Oren14Dani/autonomous-electric-car/README.md

# autonomous-electric-car
C++ programming development of a autonomous (self driving) vehicle system , using 2 Microcontrollers: Arduino Mega and Arduino Uno
