Oren14Dani/autonomous-electric-car/project description.pdf

חזור לתוכן עניינים

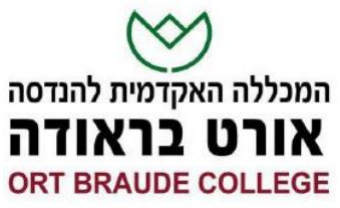
[picture p1: figure]

## פרויקט תחרותי

שם הסטודנט, תעודת זהות, מייל: סער גוזלן , 204188403 , il.ac.braude.e@gozlan.saar

שם הסטודנט, תעודת זהות, מייל: אורן דנילוב , 203824545 , com.gmail@dani14oren

שם הסטודנט, תעודת זהות, מייל: שמעון קריכלי 212141428, , il.ac.braude.e@kricheli.shimon

מנחה: ד"ר בטו כץ

תאריך: 24.8.22

מחלקה: הנדסת חשמל ואלקטרוניקה

## תוכן עניינים

מבוא | : 4
תיאור המערכת | : 4

## מפתח איורים

4 | 1 Figure
5 | 2 Figure (https://ebraude-my.sharepoint.com/personal/oren_danilov_e_braude_ac_il/Documents/STUDY/competitive%20project/ספר%20פרויקט.docx)
7 | 3 Figure
7 | 4 Figure
8 | 5 Figure
8 | 6 Figure (https://ebraude-my.sharepoint.com/personal/oren_danilov_e_braude_ac_il/Documents/STUDY/competitive%20project/ספר%20פרויקט.docx)
8 | 7 Figure (https://ebraude-my.sharepoint.com/personal/oren_danilov_e_braude_ac_il/Documents/STUDY/competitive%20project/ספר%20פרויקט.docx)
8 | 8 Figure (https://ebraude-my.sharepoint.com/personal/oren_danilov_e_braude_ac_il/Documents/STUDY/competitive%20project/ספר%20פרויקט.docx)
9 | 9 Figure
9 | 10 Figure (https://ebraude-my.sharepoint.com/personal/oren_danilov_e_braude_ac_il/Documents/STUDY/competitive%20project/ספר%20פרויקט.docx)
10 | 11 Figure (https://ebraude-my.sharepoint.com/personal/oren_danilov_e_braude_ac_il/Documents/STUDY/competitive%20project/ספר%20פרויקט.docx)
10 | 12 Figure (https://ebraude-my.sharepoint.com/personal/oren_danilov_e_braude_ac_il/Documents/STUDY/competitive%20project/ספר%20פרויקט.docx)
10 | 13 Figure (https://ebraude-my.sharepoint.com/personal/oren_danilov_e_braude_ac_il/Documents/STUDY/competitive%20project/ספר%20פרויקט.docx)
10 | 14 Figure (https://ebraude-my.sharepoint.com/personal/oren_danilov_e_braude_ac_il/Documents/STUDY/competitive%20project/ספר%20פרויקט.docx)
10 | 15 Figure (https://ebraude-my.sharepoint.com/personal/oren_danilov_e_braude_ac_il/Documents/STUDY/competitive%20project/ספר%20פרויקט.docx)
11 | 16 Figure
11 | 17 Figure
12 | 18 Figure (https://ebraude-my.sharepoint.com/personal/oren_danilov_e_braude_ac_il/Documents/STUDY/competitive%20project/ספר%20פרויקט.docx)
12 | 19 Figure (https://ebraude-my.sharepoint.com/personal/oren_danilov_e_braude_ac_il/Documents/STUDY/competitive%20project/ספר%20פרויקט.docx)
12 | 20 Figure (https://ebraude-my.sharepoint.com/personal/oren_danilov_e_braude_ac_il/Documents/STUDY/competitive%20project/ספר%20פרויקט.docx)
13 | 21 Figure
14 | 22 Figure
16 | 23 Figure
17 | 24 Figure (https://ebraude-my.sharepoint.com/personal/oren_danilov_e_braude_ac_il/Documents/STUDY/competitive%20project/ספר%20פרויקט.docx)

## מבוא:

פרויקט זה עוסק בבנייה ותכנון של מערכת רכב אוטונומי תחרותי. מטרת הפרויקט הינה ניצחון בתחרות שבה מערכת הרכב, שעליו נמצא מקלט IR, צריך למצוא ולהגיע למקור של אות IR שמשודר במרחב על ידי משדר שנמצא בצידו האחר של המסדרון. כלומר, הרכב צריך לחפש ולהתביית על אות המשדר ולהגיע אליו. הסטודנטים בתחרות מחולקים לצוותים, ומכל צוות נדרש לבנות רכב אוטונומי תחרותי אשר תבצע 3 מסלולים שונים
.1 העגלה מוסטת בזווית של כ- 45 מעלות ביחס למשדר ללא מכשולים. .2 העגלה מיושרת עם המקור, אך ישנם שני מכשולים בדרך שמונעים קו ראיה בין המשדר למקלט, על הרכב למצוא את האות תוך התחמקות מהמכשולים ולהגיע אליו. .3 העגלה מוסטת בזווית של כ- 45 מעלות ביחס למשדר, אך הפעם עם מכשול בדרך. בנוסף, ישנו רכב נוסף במסלול שמתחרה איתנו.
את המסלולים הרכב צריך לבצע בזמן הקצר ביותר.

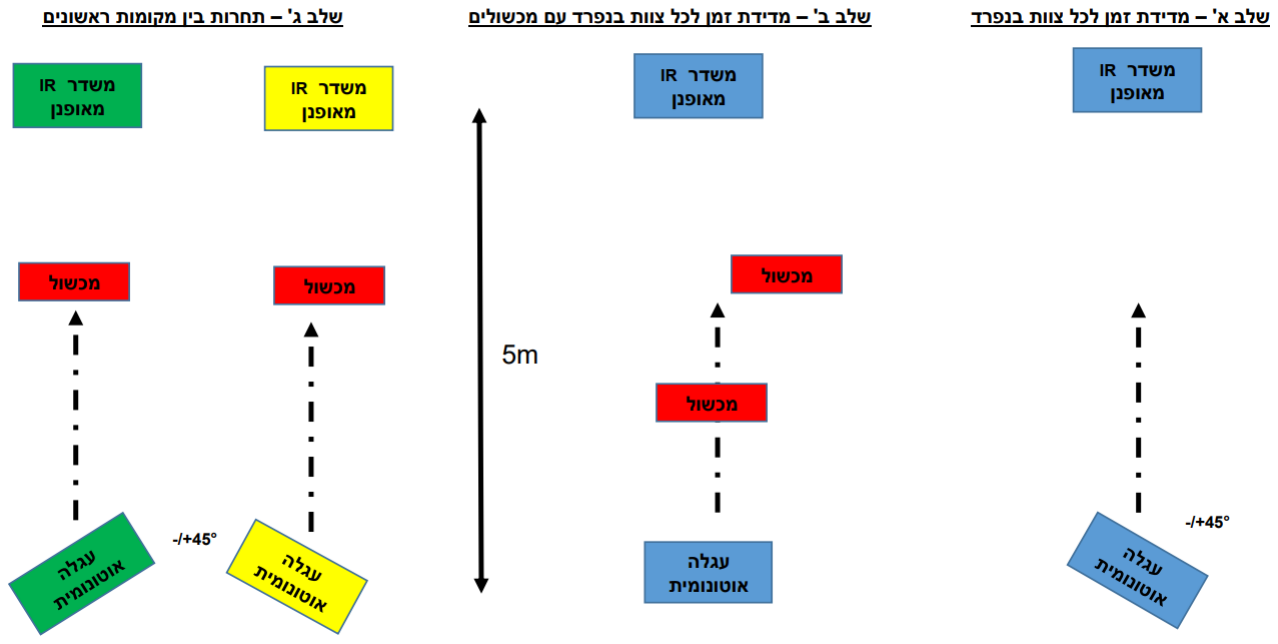
[picture p2: figure]

1 Figure

## תיאור המערכת:

המערכת בנויה מ2 מערכות עיקריות: מערכת שידור ו מערכת קליטה ובקרה.

מערכת השידור

מורכב מבקר Nano Arduino המחובר ל 3 משדרי 333IR, אשר משדרים לחלל אות בתדר kHz38 מאופנן PWM כך שאות המידע הוא גל ריבועי בתדרים Hz100 או Hz200 בהתאם למצב מתג ברירת התדרים.

מערכת הקליטה ובקרה

זה בעצם חלק מהמערכת הכוללת של הרכב.

מכיל 3 מקלטי 4838TSOP אשר אמונים על קליטת האות ופעולת דה-מודולציה על מנת לקבל את אות המידע ללא האות הנושא, כלומר, האות שהארדואינו קולט הוא אות המידע בלבד בתדרים Hz100 או Hz.200 המקלטים עצמם מבצעים דה-מודולציה.

את המקלטים הנחנו על גובה על מנת שיוכלו לקלוט יותר טוב וללא הפרעות וחסימות שיכולות להיווצר על ידי הרכיבים השונים שנמצאים על הרכב ובנוסף לכך עטפנו גליל קטן מסביב למקלט הראשי באיזולירבנד שחור על מנת שלא ייקלטו הפרעות כיוון שבשונה משני מהקלטים האחרים אין לו הגנה מהחזרים.

לרכב חיברנו גם 4 חישני מרחק -04HCSR על מנת שנוכל להתחמק ממכשולים ולכל חיישן מרחק כזה הוספנו נורת חיווי על מנת שנוכל לראות ויזואלית מתי המרחק שקולטים החיישנים קטן ממרחק הסף שהגדרנו למערכת.

את הגלגלים של הרכב אנו מניעים בעזרת 4 מנועי DC פשוטים המחוברים ל D293L

Shield Motor – רכיב הייעודי לארדואינו מגה/ אונו. רכיב זה מכיל 2 דרייברים למנועים שבעזרתם ניתן לחבר את מהנועים לארדואינו. לא ניתן לחבר את המנועים ישירות לארדואינו מכיוון שייתכן מצב שבו המנועים ייצרכו יותר זרם ממה שהפינים של הארדואינו מסוגלים לתת. את כל המערכת שמחוברת לרכב מפעילות 3 סוללות V3.7 מסוג 18650 שמחוברות לכניסת המתח של L293D Shield ה

דרישות המערכת

- המערכת תדע לזהות מקור IR בודד אשר נמצא בסוף המסלול, להתמקד עליו ולדעת לכוון את העגלה האוטונומית לכיוונו, תוך הימנעות ממכשולים ועצמים קיימים לאורך המסלול.
- המערכת תהיה מבוססת על בקר מסוג Arduino מקליטי IR ומשדרי IR , אשר ישמשו למציאת מקור השידור.
- המערכת תדע לנוע במרחב על גבי מרכב וגלגלים כפי שהוגדרו במשימה.
- הרכב יגיע ליעד לפחות באחד מהמסלולים - העגלה צריכה להגיע אל קרבת המשדר )רדיוס של 20 ס"מ( בזמן הקצר ביותר.

מפרט פונקציונלי

- יכולת קליטה והתבייתות על מקור IR ונסיעה אליו.
- יכולת זיהוי מכשולים ועצמים שונים בדרך והימנעות מפגיעה.
- יכולת נסיעה אוטונומית במסלול ללא התערבות אדם.
- יכולת סינון החזרי אור אשר מתחזים לשידור IR.

2 Figure

## מפרט טכני

| | מכלול תפקיד רכיבים
Arduino Nano בקר • • מתג בחירת תדר • 3 משדרי -333IR עם תדר גל נושא kHz38 mA20 • מסופק על ידי שנאי V5 מרשת החשמל | • יצירת ושידור אות המידע בתדרים Hz100/200 | מכלול שידור Tramission module
Arduino Mega • TSOP4838 receiver 3 • (de-modulator included) | • דה-מודולציה | מכלול קליטה module Receiver • קליטת אות ה IR-המאופנן
L293D motor driver • shield • 4 מנועי DC | • אחראי על נסיעת הרכב – מקבל פקודות מהארדואינו | מכלול הנעה
- 4 חיישני מרחק -HCSR 04 • נורות חיווי לכל חיישן • מרחק מקסימלי: m4 • מרחק מינימלי: cm2 | • זיהוי מכשולים • מניעת התנגשות | מכלול בלימה
Arduino Mega • • מסופק על ידי 3 סוללות 18650 סך הכל 11.1v | • עיבוד הנתונים • מתן פקודות לרכיבים שונים על פי התכנון | מכלול שליטה ובקרה

## תרשים מלבנים

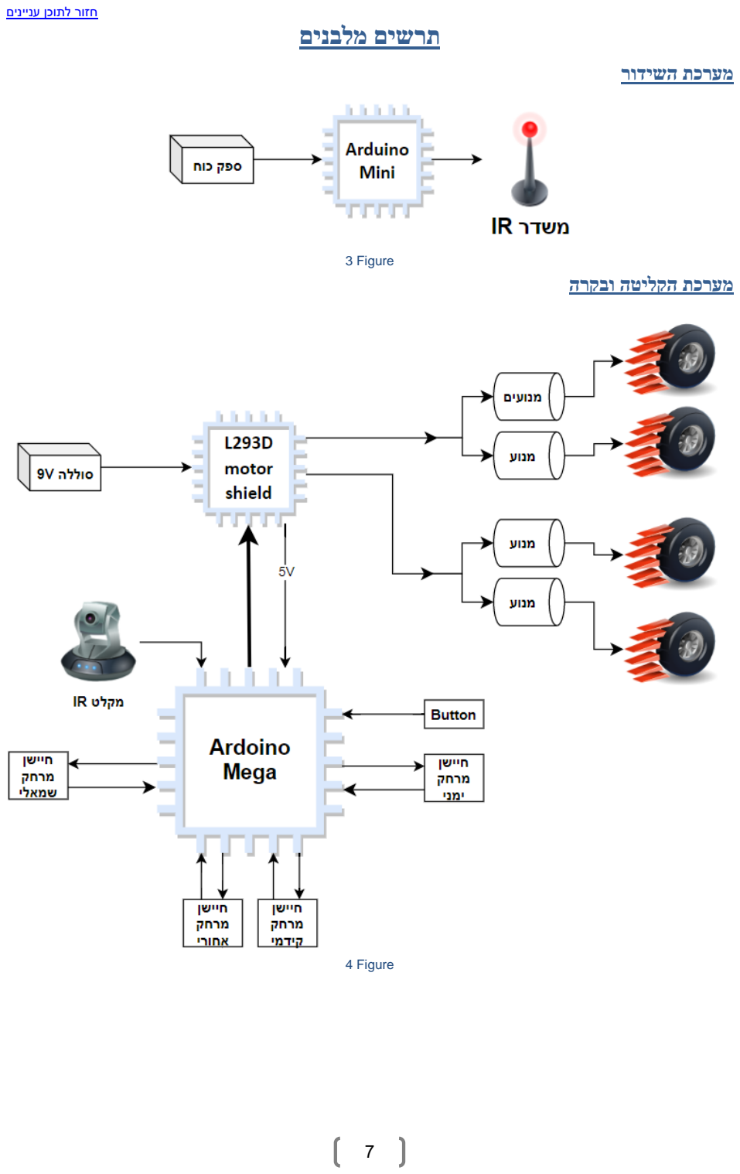
[picture p3: page 7]

מערכת השידור

3 Figure
מערכת הקליטה ו בקרה

4 Figure

## פירוט מכלולי המערכת

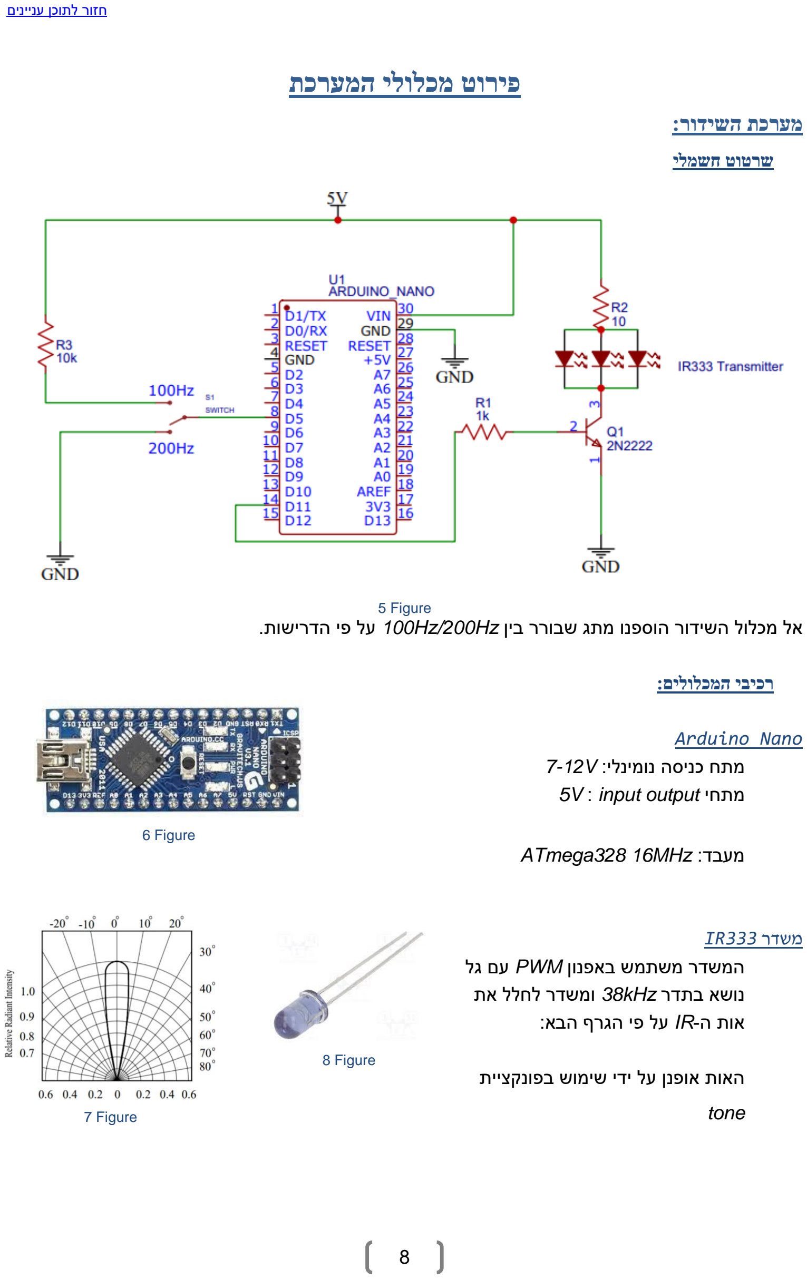
[picture p4: page 8]

7 Figure

מערכת השידור:

שרטוט חשמלי

5 Figure
אל מכלול השידור הוספנו מתג שבורר בין Hz/200Hz100 על פי הדרישות.

רכיבי המכלולים:

Arduino Nano
מתח כניסה נומינלי: V7-12
5V : input output | מתחי
ATmega328 16MHz : | מעבד

משדר 333IR
המשדר משתמש באפנון PWM עם גל נושא בתדר kHz38 ומשדר לחלל את אות ה-IR על פי הגרף הבא:

האות אופנן על ידי שימוש בפונקציית

tone

6 Figure

8 Figure

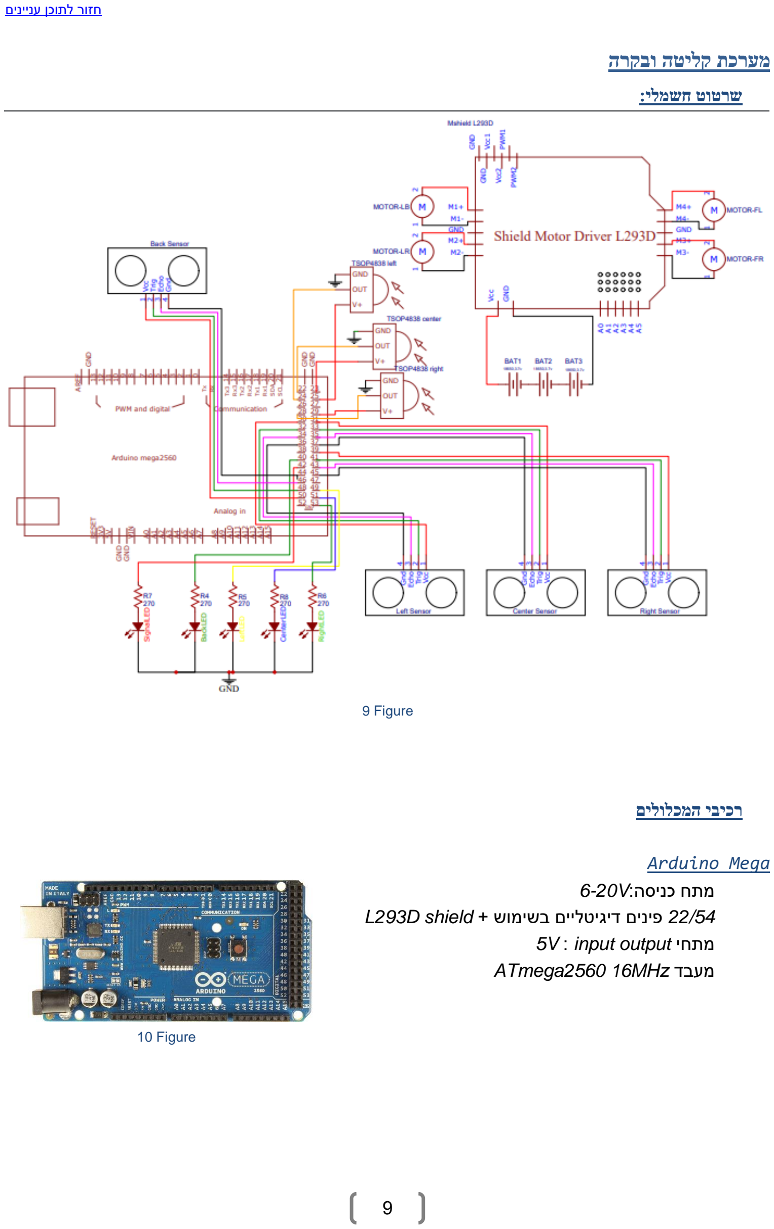
[picture p5: page 9]

מערכת קליטה ובקרה

שרטוט חשמלי:

9 Figure

רכיבי המכלולים

Arduino Mega
מתח כניסה:V6-20
22/54 פינים דיגיטליים בשימוש + shield D293L
5V : input output | מתחי
ATmega2560 16MHz | מעבד

10 Figure

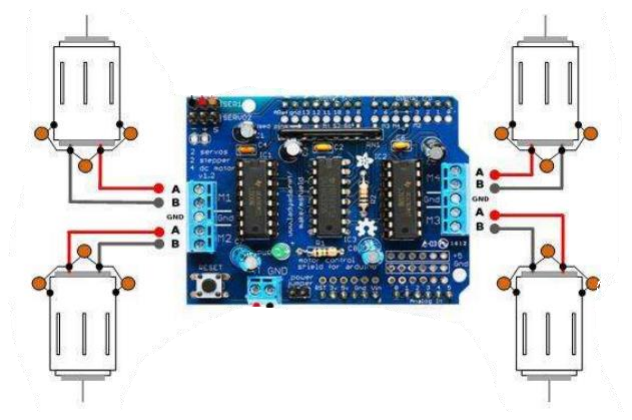
[picture p6: figure]
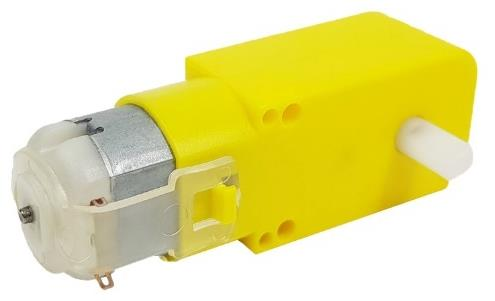
[picture p7: figure]

12 Figure

L293D Moter Driver Shield
מחובר ל- 4 מנועי DC
מתחים: V6-15
זרם למנוע: A1.2

DC motor
4 מנועי DC
מתחים: V4.5-9
זרם תחת עומס mA250~

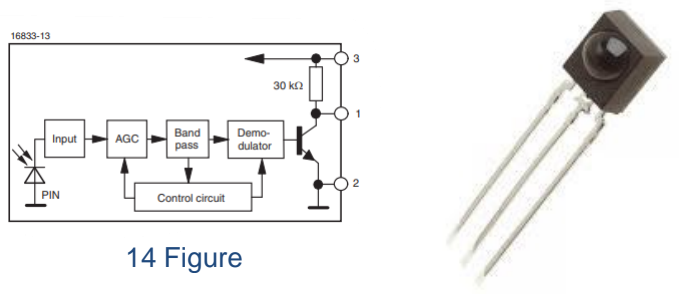
[picture p8: figure]
14 Figure

TSOP4838 IR receiver
Included de-modulator
מתחים: V2.5-5.5
טווח קליטה: kHz30-56

HCST-04
4 חיישני מרחק אולטרא סוני -04HCSR מתח וזרם עבודה: mA15 , V5
טווח מרחקים: m] ,4 0.02[

11 Figure

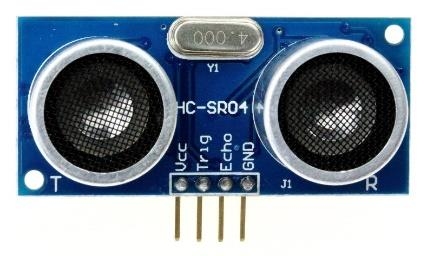
[picture p9: figure]

15 Figure

13 Figure

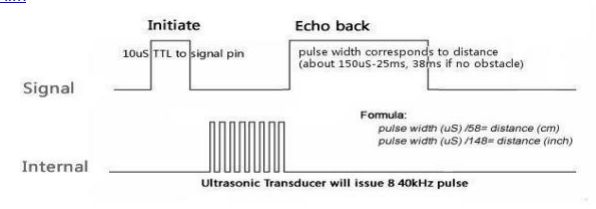
[picture p10: figure]

16 Figure
אופן מדידת אורך זמן פולס ECHO על ידי המערכת: החיישן מקבל מהארדואינו Trigger למשך 10 מיקרו שניות ולאחר מכן שולח אות בתדר kHz40 ומרים את Echo. האות עובר בחלל ולאחר מכן מוחזר אל הרכיב וכשזה קורה Echo יורד. הרכיב מודד את הזמן שפין Echo היה גבוהה.

חישוב המרחק
ע"י שימוש בנוסחה הפיזיקלית: Distance = time ∙ velocity נבצע חישוב למרחק שעבר אות ECHO מרגע שעזב את החיישן, פגע בעצם במרחב הוחזר בחזרה אל החיישן, כתלות במהירות האות שהיא מהירות הקול.

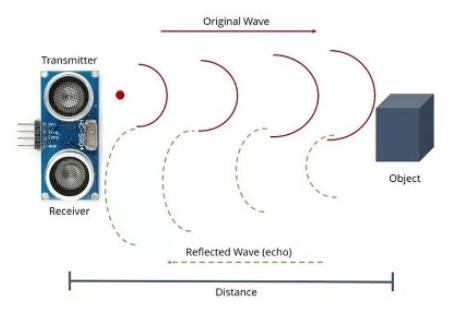
[picture p11: figure]

17 Figure
נשים לב שהאות במסעו הלוך וחזור למעשה עבר את המרחק distance פעמיים, לכן נחלק את התוצאה פי .2

Distance =

time ∙ velocity
2

Distance [m] =

ECHOtime[μ sec] ∙ Speed of Sound in air [

m
sec]

2

=

ECHOtime[μ sec] ∙ 343 [

m
sec]

2

= ECHOtime[μ sec] ∙

343
2

[

m
sec

]

נעבור ליחידות מרחק בcm:

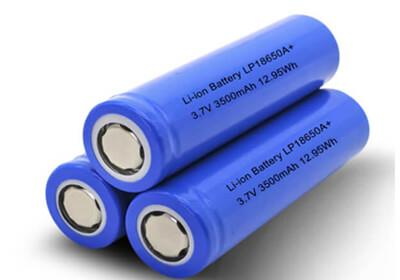
[picture p12: figure]

18 Figure

distance[cm] = ECHOtime[μ sec] ∙ 2

[

cm
c sec

] = ECHOtime[μ sec] ∙
2

c

[

cm
sec

]

= ECHOtime[μ sec] ∙

343
2

μ
c

[

cm
μ sec] ≈ ECHOtime[μ sec] ∙

1
58 [

cm
μ sec]

קיבלנו נוסחא לחישוב המרחק בעזרת מהירות הקול:

distance ≈

ECHOtime
58 [cm]

לפי הנוסחה שקיבלנו - נקבל את המרחק שנמדד בסנטימטר כאשר נחלק מדידת הזמן של האות פי 58 . לכן גם נוודא לקחת את זמן המחזור במיקרו שניות.

הערה: הרגישות שלנו תהיה לפי ס"מ, ויהיה עיגול מטה למספרים שלמים )משתמשים במשתנה int). כלומר, עבור מרחק של 45.8 ס"מ נראה פשוט 45 ס"מ.

מקורות מתח
כל המערכת מסופקת על ידי 3 סוללות מסוג 18650 בעלות מתח V3.7 כל אחת .

פעולת משדר-מקלט:

אחרי דמודולציה )מקלט( Hz:100 אחרי דמודולציה )מקלט( Hz:200

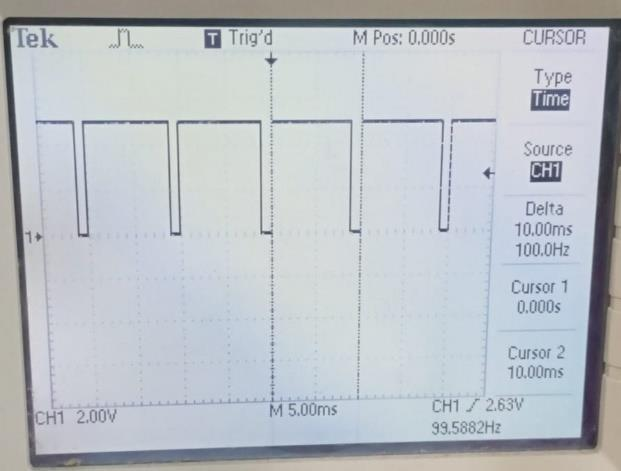
[picture p13: figure]

כפי שניתן לראות קיבלנו אותות נקיים לשני התדרים.

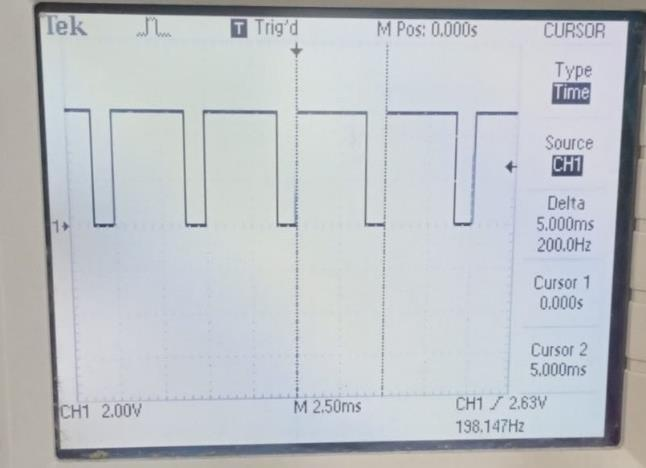
[picture p14: figure]

ניתן לראות שכיוונו את המשדר כך שישדר ms1 של LOW בשני התדרים וכך כיילנו אותו עם המקלט ובדקנו אם האות המתקבל הוא יציב.

19 Figure 20 Figure

## תרשים זרימה

תרשים הזרימה ממחיש את הלוגיקה העומדת מאחור הקוד.

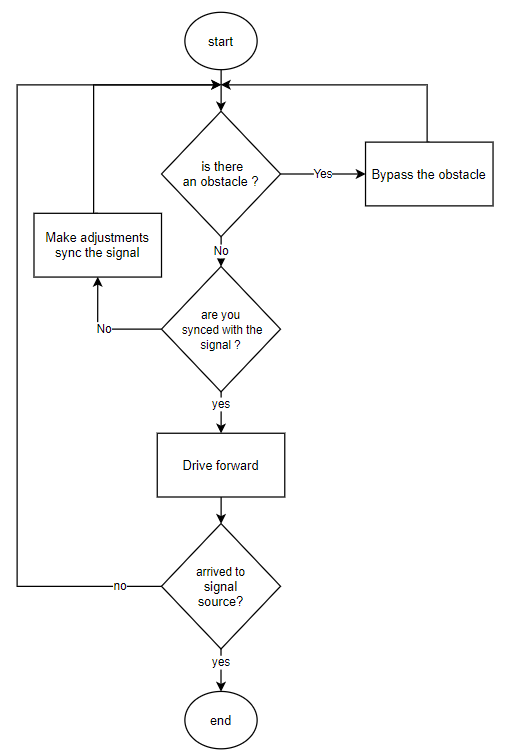
[picture p15: figure]

21 Figure

## מכונת מצבים

מכונת המצבים ממחישה את אופן מימוש הקוד.

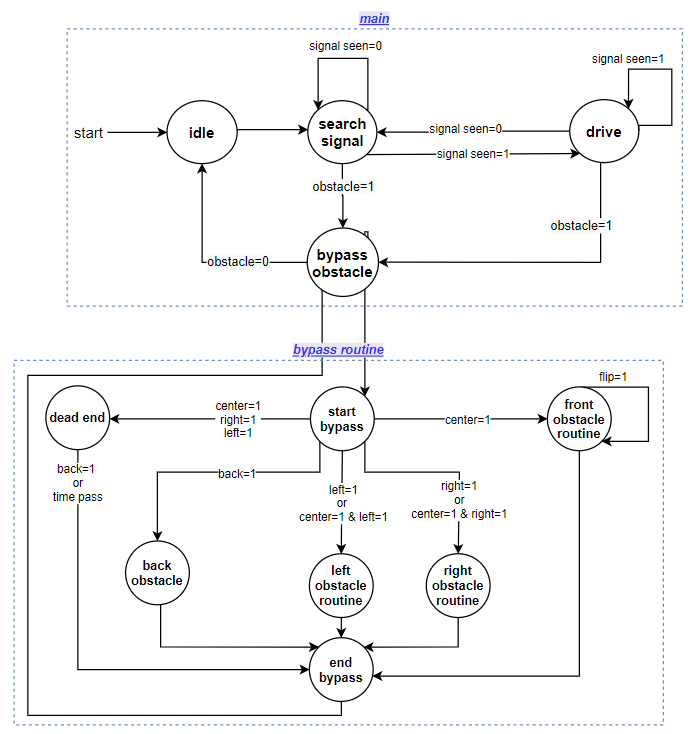
[picture p16: figure]

22 Figure

## שיקולי תכנון

.1 החלטנו לבנות את הרכב עם 3 מקלטים ושלושה חיישני מרחק בזוויות ,0 ,+45 ,-45 על מנת שנוכל לזהות מכשולים שנמצאים מלפני הרכב ושנדע מאיזה צד לעקוף אותם.

.2 בחרנו לבנות את המשדר עם 3 נורות IR כדי הגדיל את המפתח )"הקונוס"( ליותר מ 20 מעלות.

.3 בחרנו לעבוד עם סוללות נטענות מסוג 18650 בעלי 3.7 וולט מכיוון שהם נחשבות אמינות ויעילות לאורך זמן ובנוסף המתח מתאים לדרישות המערכת שהם עד 12 וולט עבור הארדואינו והשילד

.4 הבעיה - המקלט קלט יותר מידי החזרות של האות. הפתרון - צמצמנו את שדה הראיה שלו על ידי ליפ וף של גליל סביבו והקטנת המפתח של הגליל בהתאם לתוצאות שראינו בסקופ.

.5 הבעיה - היה קושי באינטגרציה של המערכת - המערכת לא עבדה כמו שציפינו בכך שלא התחמקה ממכשולים.
הפתרון - חילקנו את הקוד בצורה מסודרת לפונקציות כך שניתן לדבג את הקוד בצורה יעילה וכך מצאנו את הבעיות.

.6 הבעיה - ריבוי חוטים הקשה על חיבור כלל המערכת. הפתרון - על מנת להתמודד עם הבעיה ביצענו חיבור קודם בתוך כל תת מערכת, ולבסוף חיבור בין תתי מערכות.

.7 הבעיה - הרכיבים והחיבורים היו רופפים, ולפעמים התנתקו במהלך הנסיעה. הפתרון - בחיברנו את הרכיבים למרכב באמצעות ברגים ודבק חזק, ובנוסף למדנו גם כיצד להלחים וביצענו הלחמה של החוטים.

.8 הבעיה - הרכב היה נראה עמוס ולא מסודר, ולא היה מקום לכל הסוללות. הפתרון - הרכבנו וחיווטנו מחדש את הרכיבים )את מכלול השידור חיווטנו בשיטת up-wire). הורדנו מקור מתח אחד והגדלנו את המתח במקור הנותר.

.9 הרכבנו את פלטפורמת הרכב כך שהמנועים נמצאים בין הקומות, על מנת שהחוטים לא יסתבכו בגלגלים או רכיבים אחרים.

.10התלבטות האם לעשות שימוש בדרייבר המנוע בצורתו המקורית או בצורת שילד המובנה לארדואינו .(Shield Motor D293L(בחרנו בשילד כדי לחסוך חיווטים ולקבל צורה יותר אסטתית. זה אמנם תופס את הפינים בבקר, אך מאחר ויש עוד כ20 פינים פנויים בבקר זה מספיק לנו.

.11ניסינו בהתחלה להסתפק רק במקלט אחד בלבד ולעשות הפרדה בין קודים – קוד אחד למסלול הראשון וקוד אחד למסלול השני. פתרון זה לא היה אידיאלי כי נתקלנו בקשיים במציאת האות עם מקלט אחד בלבד ולכן הגענו להחלטה להוסיף עוד 2 מקלטים מקדימה בזווית של 45 מעלות לכל צד על מנת למצוא מיידית את האות במסלול הראשון.

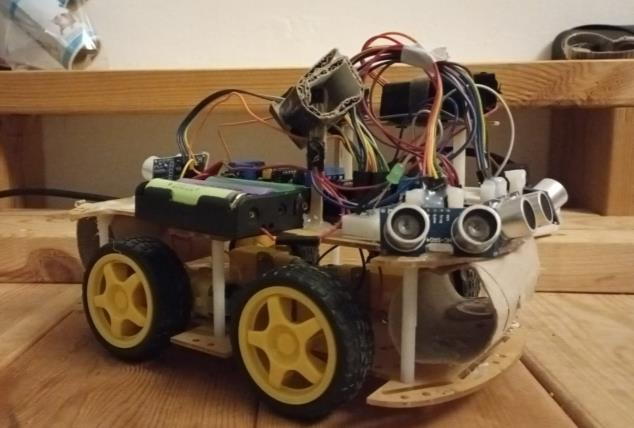
[picture p17: figure]

23 Figure

## מאפיינים חשמליים

מכלול שידור

200Hz | 100Hz
VB = 0.7V , VC = 4V | VB = 0.7V , VC = 3.7V

VC > VB > VE → transistor ACTIVE

אנחנו מצפים שהגבר הזרם יהיה פי 100 לפי דף הנתונים של הטרנזיסטור

Ibase200Hz =

0.51
1k

[

V
Ω
] = 0.51mA | Ibase100Hz =

0.62
1k

[

V
Ω

] = 0.62mA

ICollector200Hz =

0.52
10 [

V
Ω
] = 52mA | ICollector100Hz =

0.65
10 [

V
Ω

] = 65mA

לאחר חישובים הוכחנו שאכן הציפייה שלנו התקיימה. לפי דף הנתונים של משדר ה IR ניתן לספק זרם ממושך עד mA100ולכן יש באפשרותינו לספק קצת יותר זרם, נעשה זאת על ידי הקטנת נגד 2R מ- 10 ל- 7 אוהם. )על ידי חיבור במקביל עם נגד 22 אוהם(

Rtℎeory =

10 ∗ 22
10 + 22 = 6.875Ω , Rpractically = 7Ω

לאחר הקטנת נגד 2R ל7- אוהם מדדנו וקיבלנו את הערכים הבאים:

Ibase200Hz =

0.51
1k

[

V
Ω
] = 0.51mA | Ibase100Hz =

0.62
1k

[

V
Ω

] = 0.62mA

ICollector200Hz =

0.44
7

[

V
Ω
] = 63mA | ICollector100Hz =

0.65
10 [

V
Ω

] = 65mA

כפי שציפינו קיבלנו עליה בזרם -< שיפור בהספק השידור

מכלול קליטה

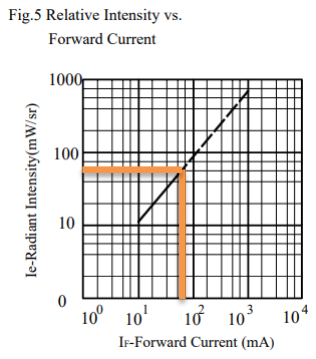
[picture p18: figure]

מכלול הקליטה מחובר ל 3 סוללות בעלות 3.7 וולט כל אחת לכם על סך 11.1 וולט. מנועי הDC צורכים במקסימום 1 אמפר על פי מדידות.

## אתגרים הנדסיים

- התגברות על הספק חלש מידי שמוציא המשדר על פי המפורט לעיל.
- למידה וחקר על רכיבים שלא השתמשנו בהם בעבר כמו D293L ומשדר ומקלט IR.
- קליטת האות והתבייתות עליו.
- קליטה והתחמקות ממכשולים ומניעת התגנגשויות בהם.
- תכנון פניות בלימות ונסיעות ומניעת סטיות של הרכב.
- אינטגרציה בין כל חלקי המערכת.
- ליטוש פרמטרים ואופטימיזציה סופית.

## כלי פיתוח

Visual Studio .1
Arduino IDE .2
draw.IO .3
easyEDA .4

24 Figure

## מקורות:

https://github.com/CuriosityGym/MotorDriver/blob/master/src/MotorDriver.cpp/https://www.arduino.cc/reference/en/language/functions/advanced-io/pulseinhttps://www.ali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
